Tatum1234/kahvibotti/test-data/calibration_log_20260927_1521.txt

Restored: machine on, carafe on, basket off, pot 0 g
!!! left HX711 not answering at start
>>> event: Käynnistys (alkuperäinen versio, syy: virta kytketty) 0 0
>>> Käynnistys (alkuperäinen versio, syy: virta kytketty)

>>> state: Tyhjä
t= 149613807 us  left :  -770224 raw   right:    -1826 raw    rawT=  -772050
t= 150437807 us  left :  -770229 raw   right:    -1812 raw    rawT=  -772041
t= 151261807 us  left :  -770199 raw   right:    -1844 raw    rawT=  -772043
t= 152084798 us  left :  -770179 raw   right:    -1841 raw    rawT=  -772020
t= 152826796 us  left :  -770173 raw   right:    -1890 raw    rawT=  -772063
t= 153649802 us  left :  -770189 raw   right:    -1909 raw    rawT=  -772098
t= 154473808 us  left :  -770124 raw   right:    -1910 raw    rawT=  -772034
t= 155214815 us  left :  -770253 raw   right:    -1974 raw    rawT=  -772227
t= 156038798 us  left :  -770239 raw   right:    -1875 raw    rawT=  -772114
t= 156862802 us  left :  -770227 raw   right:    -1867 raw    rawT=  -772094
t= 157603807 us  left :  -770182 raw   right:    -1882 raw    rawT=  -772064
t= 158427806 us  left :  -770238 raw   right:    -1864 raw    rawT=  -772102
t= 159251806 us  left :  -770158 raw   right:    -1841 raw    rawT=  -771999
t= 159992803 us  left :  -770184 raw   right:    -1855 raw    rawT=  -772039
t= 160816801 us  left :  -770172 raw   right:    -1921 raw    rawT=  -772093
t= 161639799 us  left :  -770178 raw   right:    -1882 raw    rawT=  -772060
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
t= 293243808 us  left :  -755480 raw   right:    53554 raw    rawT=  -701926
t= 294066807 us  left :  -755510 raw   right:    53580 raw    rawT=  -701930
t= 294808807 us  left :  -755553 raw   right:    53567 raw    rawT=  -701986
t= 295631808 us  left :  -755504 raw   right:    53547 raw    rawT=  -701957
t= 296455813 us  left :  -755506 raw   right:    53537 raw    rawT=  -701969
t= 297196799 us  left :  -755497 raw   right:    53554 raw    rawT=  -701943
t= 298020793 us  left :  -755482 raw   right:    53560 raw    rawT=  -701922
t= 298843821 us  left :  -755512 raw   right:    53556 raw    rawT=  -701956
t= 299584799 us  left :  -755510 raw   right:    53552 raw    rawT=  -701958
t= 300408800 us  left :  -755496 raw   right:    53539 raw    rawT=  -701957
t= 301231808 us  left :  -755504 raw   right:    53555 raw    rawT=  -701949
t= 302055807 us  left :  -755500 raw   right:    53600 raw    rawT=  -701900
t= 302796808 us  left :  -755517 raw   right:    53612 raw    rawT=  -701905
t= 303620807 us  left :  -755496 raw   right:    53607 raw    rawT=  -701889
t= 304443806 us  left :  -755531 raw   right:    53624 raw    rawT=  -701907
t= 305185798 us  left :  -755490 raw   right:    53606 raw    rawT=  -701884
t= 306008797 us  left :  -755508 raw   right:    53660 raw    rawT=  -701848
t= 306832805 us  left :  -755474 raw   right:    53656 raw    rawT=  -701818
t= 307573807 us  left :  -755527 raw   right:    53681 raw    rawT=  -701846
t= 308396811 us  left :  -755575 raw   right:    53722 raw    rawT=  -701853
t= 309220801 us  left :  -755536 raw   right:    53729 raw    rawT=  -701807
t= 309961806 us  left :  -755482 raw   right:    53691 raw    rawT=  -701791
t= 310785801 us  left :  -755501 raw   right:    53723 raw    rawT=  -701778
t= 311608802 us  left :  -755516 raw   right:    53726 raw    rawT=  -701790
t= 312350811 us  left :  -755527 raw   right:    53732 raw    rawT=  -701795

############ MARK t= 312860717 us: S3 carafe empty OUT r2 ############

t= 313173802 us  left :  -755567 raw   right:    53750 raw    rawT=  -701817
t= 313997802 us  left :  -755563 raw   right:    53780 raw    rawT=  -701783
t= 314820816 us  left :  -755554 raw   right:    53796 raw    rawT=  -701758
t= 315561807 us  left :  -755658 raw   right:    53788 raw    rawT=  -701870
t= 316385797 us  left :  -755674 raw   right:    53802 raw    rawT=  -701872
t= 317208820 us  left :  -755656 raw   right:    53884 raw    rawT=  -701772
t= 317949807 us  left :  -755687 raw   right:    53835 raw    rawT=  -701852
t= 318772807 us  left :  -755695 raw   right:    53848 raw    rawT=  -701847
t= 319596807 us  left :  -755727 raw   right:    53885 raw    rawT=  -701842
t= 320337794 us  left :  -755722 raw   right:    53849 raw    rawT=  -701873
t= 321160807 us  left :  -755678 raw   right:    53843 raw    rawT=  -701835
t= 321984814 us  left :  -755668 raw   right:    53837 raw    rawT=  -701831
t= 322725803 us  left :  -755707 raw   right:    53863 raw    rawT=  -701844
t= 323549808 us  left :  -755620 raw   right:    53926 raw    rawT=  -701694
t= 324372807 us  left :  -755632 raw   right:    53864 raw    rawT=  -701768
t= 325113799 us  left :  -755571 raw   right:    53909 raw    rawT=  -701662
t= 325937807 us  left :  -755624 raw   right:    53903 raw    rawT=  -701721
t= 326761791 us  left :  -755611 raw   right:    42379 raw    rawT=  -713232
t= 327502780 us  left :  -809276 raw   right:   -32775 raw    rawT=  -842051
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
t= 428706807 us  left :  -771600 raw   right:    -5134 raw    rawT=  -776734
t= 429529807 us  left :  -771546 raw   right:    -5285 raw    rawT=  -776831
t= 430352800 us  left :  -771491 raw   right:    -5319 raw    rawT=  -776810
t= 431176806 us  left :  -771447 raw   right:    -5341 raw    rawT=  -776788
t= 431917807 us  left :  -771403 raw   right:    -5445 raw    rawT=  -776848
t= 432740796 us  left :  -771387 raw   right:    -5471 raw    rawT=  -776858
t= 433564811 us  left :  -771375 raw   right:    -5521 raw    rawT=  -776896
t= 434305808 us  left :  -771333 raw   right:    -5525 raw    rawT=  -776858
t= 435128798 us  left :  -771294 raw   right:    -5576 raw    rawT=  -776870
t= 435952796 us  left :  -771279 raw   right:    -5661 raw    rawT=  -776940
t= 436693795 us  left :  -771232 raw   right:    -5675 raw    rawT=  -776907
t= 437516807 us  left :  -771227 raw   right:    -5766 raw    rawT=  -776993
t= 438339807 us  left :  -771198 raw   right:    -5757 raw    rawT=  -776955
t= 439080808 us  left :  -771193 raw   right:    -5819 raw    rawT=  -777012
t= 439904807 us  left :  -771173 raw   right:    -5866 raw    rawT=  -777039
t= 440727803 us  left :  -771163 raw   right:    -5835 raw    rawT=  -776998
t= 441468796 us  left :  -771136 raw   right:    -5881 raw    rawT=  -777017
t= 442291799 us  left :  -771144 raw   right:    -5867 raw    rawT=  -777011
t= 443114808 us  left :  -771082 raw   right:    -5883 raw    rawT=  -776965
t= 443938796 us  left :  -771076 raw   right:    -5951 raw    rawT=  -777027
t= 444679799 us  left :  -771069 raw   right:    -5938 raw    rawT=  -777007
t= 445502808 us  left :  -771043 raw   right:    -5969 raw    rawT=  -777012
t= 446326806 us  left :  -770941 raw   right:    -6022 raw    rawT=  -776963
t= 447067807 us  left :  -770945 raw   right:    -6054 raw    rawT=  -776999
t= 447891807 us  left :  -771033 raw   right:    -6089 raw    rawT=  -777122
t= 448714808 us  left :  -770977 raw   right:    -6121 raw    rawT=  -777098

############ MARK t= 449171719 us: S6 carafe empty IN r3 ############

t= 449455800 us  left :  -771015 raw   right:    -6140 raw    rawT=  -777155
t= 450279801 us  left :  -770977 raw   right:    -6157 raw    rawT=  -777134
t= 451102806 us  left :  -770941 raw   right:    -6120 raw    rawT=  -777061
t= 451843795 us  left :  -770945 raw   right:    -6211 raw    rawT=  -777156
t= 452667808 us  left :  -770942 raw   right:    -6188 raw    rawT=  -777130
t= 453490807 us  left :  -770946 raw   right:    -6196 raw    rawT=  -777142
t= 454231807 us  left :  -770998 raw   right:    -6232 raw    rawT=  -777230
t= 455055807 us  left :  -770966 raw   right:    -6223 raw    rawT=  -777189
t= 455878808 us  left :  -770956 raw   right:    -6242 raw    rawT=  -777198
t= 456619807 us  left :  -770932 raw   right:    -6304 raw    rawT=  -777236
t= 457360815 us  left :  -770948 raw   right:    -6299 raw    rawT=  -777247
t= 458183874 us  left :  -770904 raw   right:    -6296 raw    rawT=  -777200
t= 458924797 us  left :  -770896 raw   right:    -6310 raw    rawT=  -777206
t= 459747812 us  left :  -770885 raw   right:    -6297 raw    rawT=  -777182
t= 460571797 us  left :  -770775 raw   right:    -6257 raw    rawT=  -777032
t= 461312803 us  left :  -770673 raw   right:    -6383 raw    rawT=  -777056
t= 462135807 us  left :  -770655 raw   right:    -6345 raw    rawT=  -777000
t= 462959796 us  left :  -764987 raw   right:    -1452 raw    rawT=  -766439
t= 463700796 us  left :  -738876 raw   right:    34253 raw    rawT=  -704623
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
t= 506844807 us  left :  -769833 raw   right:    -7179 raw    rawT=  -777012
t= 507585803 us  left :  -769850 raw   right:    -7352 raw    rawT=  -777202
t= 508408801 us  left :  -769787 raw   right:    -7295 raw    rawT=  -777082
t= 509232820 us  left :  -769792 raw   right:    -7333 raw    rawT=  -777125
t= 509973808 us  left :  -769768 raw   right:    -7309 raw    rawT=  -777077
t= 510796804 us  left :  -769793 raw   right:    -7265 raw    rawT=  -777058
t= 511620812 us  left :  -769746 raw   right:    -7342 raw    rawT=  -777088
t= 512361805 us  left :  -769718 raw   right:    -7279 raw    rawT=  -776997
t= 513184803 us  left :  -769738 raw   right:    -7408 raw    rawT=  -777146
t= 514008815 us  left :  -769700 raw   right:    -7396 raw    rawT=  -777096
t= 514749807 us  left :  -769724 raw   right:    -7355 raw    rawT=  -777079
t= 515572803 us  left :  -769700 raw   right:    -7432 raw    rawT=  -777132
t= 516395797 us  left :  -769645 raw   right:    -7403 raw    rawT=  -777048
t= 517136801 us  left :  -769648 raw   right:    -7460 raw    rawT=  -777108
t= 517959803 us  left :  -769578 raw   right:    -7425 raw    rawT=  -777003
t= 518783803 us  left :  -769616 raw   right:    -7419 raw    rawT=  -777035
t= 519606808 us  left :  -769555 raw   right:    -7453 raw    rawT=  -777008
t= 520347810 us  left :  -769519 raw   right:    -7435 raw    rawT=  -776954
t= 521170803 us  left :  -769484 raw   right:    -7458 raw    rawT=  -776942
t= 521993803 us  left :  -769527 raw   right:    -7482 raw    rawT=  -777009
t= 522734819 us  left :  -769440 raw   right:    -7535 raw    rawT=  -776975
t= 523558803 us  left :  -769432 raw   right:    -7538 raw    rawT=  -776970
t= 524381798 us  left :  -769414 raw   right:    -7575 raw    rawT=  -776989
t= 525122796 us  left :  -769373 raw   right:    -7676 raw    rawT=  -777049
t= 525945807 us  left :  -769417 raw   right:    -7617 raw    rawT=  -777034
t= 526768802 us  left :  -769341 raw   right:    -7661 raw    rawT=  -777002
t= 527509795 us  left :  -769386 raw   right:    -7679 raw    rawT=  -777065

############ MARK t= 527875688 us: S8 basket IN ############

t= 528333807 us  left :  -769400 raw   right:    -7684 raw    rawT=  -777084
t= 529156807 us  left :  -769326 raw   right:    -7742 raw    rawT=  -777068
t= 529897807 us  left :  -769307 raw   right:    -7732 raw    rawT=  -777039
t= 530721805 us  left :  -769361 raw   right:    -7700 raw    rawT=  -777061
t= 531544807 us  left :  -769344 raw   right:    -7732 raw    rawT=  -777076
t= 532368801 us  left :  -769361 raw   right:    -7755 raw    rawT=  -777116
t= 533109808 us  left :  -769407 raw   right:    -7773 raw    rawT=  -777180
t= 533932804 us  left :  -769419 raw   right:    -7770 raw    rawT=  -777189
t= 534756803 us  left :  -769395 raw   right:    -7786 raw    rawT=  -777181
t= 535497795 us  left :  -769388 raw   right:    -7780 raw    rawT=  -777168
t= 536320796 us  left :  -769367 raw   right:    -7782 raw    rawT=  -777149
t= 537144802 us  left :  -769386 raw   right:    -7845 raw    rawT=  -777231
t= 537885808 us  left :  -769318 raw   right:    -7818 raw    rawT=  -777136
t= 538708807 us  left :  -769252 raw   right:    -7826 raw    rawT=  -777078
t= 539532789 us  left :  -769410 raw   right:    -3720 raw    rawT=  -773130
t= 540273791 us  left :  -743564 raw   right:    18458 raw    rawT=  -725106
t= 541096798 us  left :  -758252 raw   right:    18781 raw    rawT=  -739471
t= 541919790 us  left :  -758344 raw   right:    19077 raw    rawT=  -739267
>>> event: Suodatinsuppilo, kansi tai porot pois (askel) 37869 0
t= 542664080 us  left :  -758395 raw   right:    19234 raw    rawT=  -739161
t= 543483799 us  left :  -759104 raw   right:    19872 raw    rawT=  -739232
t= 544307800 us  left :  -759149 raw   right:    19986 raw    rawT=  -739163
t= 545130814 us  left :  -759150 raw   right:    19923 raw    rawT=  -739227
t= 545871812 us  left :  -759175 raw   right:    19988 raw    rawT=  -739187
t= 546694811 us  left :  -759172 raw   right:    20001 raw    rawT=  -739171
t= 547517807 us  left :  -759192 raw   right:    20002 raw    rawT=  -739190
t= 548258810 us  left :  -759192 raw   right:    20062 raw    rawT=  -739130
t= 549081806 us  left :  -759208 raw   right:    20037 raw    rawT=  -739171
t= 549905801 us  left :  -759245 raw   right:    20084 raw    rawT=  -739161
t= 550646806 us  left :  -759205 raw   right:    20083 raw    rawT=  -739122
t= 551469792 us  left :  -759217 raw   right:    20147 raw    rawT=  -739070
t= 552292799 us  left :  -759209 raw   right:    20122 raw    rawT=  -739087
t= 553033804 us  left :  -759217 raw   right:    20150 raw    rawT=  -739067
t= 553856818 us  left :  -759238 raw   right:    20137 raw    rawT=  -739101
t= 554679808 us  left :  -759257 raw   right:    20144 raw    rawT=  -739113
t= 555420806 us  left :  -759235 raw   right:    20185 raw    rawT=  -739050
t= 556244807 us  left :  -759250 raw   right:    20174 raw    rawT=  -739076
t= 557067804 us  left :  -759248 raw   right:    20173 raw    rawT=  -739075
t= 557890803 us  left :  -759201 raw   right:    20199 raw    rawT=  -739002
t= 558632807 us  left :  -759221 raw   right:    20165 raw    rawT=  -739056
t= 559455799 us  left :  -759197 raw   right:    20166 raw    rawT=  -739031
t= 560278802 us  left :  -759212 raw   right:    20172 raw    rawT=  -739040
t= 561019803 us  left :  -759227 raw   right:    20136 raw    rawT=  -739091
t= 561843808 us  left :  -759187 raw   right:    20148 raw    rawT=  -739039
t= 562666807 us  left :  -759187 raw   right:    20170 raw    rawT=  -739017
t= 563407816 us  left :  -759175 raw   right:    20161 raw    rawT=  -739014
t= 564231807 us  left :  -759154 raw   right:    20139 raw    rawT=  -739015
t= 565054812 us  left :  -759178 raw   right:    20135 raw    rawT=  -739043
t= 565795802 us  left :  -759173 raw   right:    20121 raw    rawT=  -739052
t= 566618792 us  left :  -759129 raw   right:    20143 raw    rawT=  -738986
t= 567441855 us  left :  -759134 raw   right:    20124 raw    rawT=  -739010
t= 568182800 us  left :  -759156 raw   right:    20104 raw    rawT=  -739052
t= 569005800 us  left :  -759119 raw   right:    20085 raw    rawT=  -739034
t= 569829805 us  left :  -759141 raw   right:    20089 raw    rawT=  -739052
t= 570652806 us  left :  -759122 raw   right:    20085 raw    rawT=  -739037
t= 571393807 us  left :  -759121 raw   right:    20093 raw    rawT=  -739028
t= 572216823 us  left :  -759135 raw   right:    20064 raw    rawT=  -739071
t= 573039807 us  left :  -759111 raw   right:    20047 raw    rawT=  -739064
t= 573780800 us  left :  -759074 raw   right:    20055 raw    rawT=  -739019

############ MARK t= 573970708 us: S9 basket OUT r2 ############

t= 574603796 us  left :  -759169 raw   right:    20051 raw    rawT=  -739118
t= 575427806 us  left :  -759139 raw   right:    20104 raw    rawT=  -739035
t= 576168795 us  left :  -759161 raw   right:    20022 raw    rawT=  -739139
t= 576991798 us  left :  -759111 raw   right:    20068 raw    rawT=  -739043
t= 577814806 us  left :  -759137 raw   right:    20071 raw    rawT=  -739066
t= 578555807 us  left :  -759115 raw   right:    20042 raw    rawT=  -739073
t= 579378807 us  left :  -759151 raw   right:    20069 raw    rawT=  -739082
t= 580201807 us  left :  -759156 raw   right:    20058 raw    rawT=  -739098
t= 580942802 us  left :  -759088 raw   right:    19981 raw    rawT=  -739107
t= 581766805 us  left :  -759077 raw   right:    20007 raw    rawT=  -739070
t= 582589807 us  left :  -759115 raw   right:    19999 raw    rawT=  -739116
t= 583412799 us  left :  -759026 raw   right:    20025 raw    rawT=  -739001
t= 584153813 us  left :  -759001 raw   right:    19551 raw    rawT=  -739450
t= 584976797 us  left :  -758358 raw   right:    19301 raw    rawT=  -739057
t= 585799802 us  left :  -758350 raw   right:    17553 raw    rawT=  -740797
t= 586540791 us  left :  -777399 raw   right:    14690 raw    rawT=  -762709
t= 587364792 us  left :  -765990 raw   right:      194 raw    rawT=  -765796
t= 588187791 us  left :  -765774 raw   right:    11451 raw    rawT=  -754323
t= 588928792 us  left :  -768636 raw   right:    -7564 raw    rawT=  -776200
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
t= 631985811 us  left :  -755219 raw   right:    -5849 raw    rawT=  -761068
t= 632809812 us  left :  -755165 raw   right:    -5854 raw    rawT=  -761019
t= 633632811 us  left :  -755179 raw   right:    -5822 raw    rawT=  -761001
t= 634373811 us  left :  -755179 raw   right:    -5859 raw    rawT=  -761038
t= 635197806 us  left :  -755146 raw   right:    -5858 raw    rawT=  -761004
t= 636020802 us  left :  -755155 raw   right:    -5855 raw    rawT=  -761010
t= 636844799 us  left :  -755138 raw   right:    -5857 raw    rawT=  -760995
t= 637585808 us  left :  -755149 raw   right:    -5896 raw    rawT=  -761045
t= 638408800 us  left :  -755134 raw   right:    -5873 raw    rawT=  -761007
t= 639231798 us  left :  -755077 raw   right:    -5875 raw    rawT=  -760952
t= 639973798 us  left :  -755046 raw   right:    -5937 raw    rawT=  -760983
t= 640796808 us  left :  -755048 raw   right:    -5913 raw    rawT=  -760961
t= 641619807 us  left :  -755048 raw   right:    -5918 raw    rawT=  -760966
t= 642360807 us  left :  -755027 raw   right:    -5981 raw    rawT=  -761008
t= 643184806 us  left :  -755001 raw   right:    -5947 raw    rawT=  -760948
t= 644007814 us  left :  -755007 raw   right:    -5966 raw    rawT=  -760973
t= 644748797 us  left :  -754967 raw   right:    -6032 raw    rawT=  -760999
t= 645572796 us  left :  -754998 raw   right:    -5987 raw    rawT=  -760985
t= 646395806 us  left :  -754982 raw   right:    -6021 raw    rawT=  -761003
t= 647136797 us  left :  -754996 raw   right:    -6037 raw    rawT=  -761033
t= 647960799 us  left :  -754988 raw   right:    -6067 raw    rawT=  -761055
t= 648783806 us  left :  -754946 raw   right:    -6031 raw    rawT=  -760977
t= 649524807 us  left :  -754948 raw   right:    -6040 raw    rawT=  -760988
t= 650348807 us  left :  -754958 raw   right:    -6073 raw    rawT=  -761031
t= 651171818 us  left :  -754943 raw   right:    -6040 raw    rawT=  -760983
t= 651994807 us  left :  -754931 raw   right:    -6106 raw    rawT=  -761037
t= 652735794 us  left :  -754909 raw   right:    -6093 raw    rawT=  -761002

############ MARK t= 653356720 us: S11 reservoir lid OFF ############

t= 653559796 us  left :  -754899 raw   right:    -6132 raw    rawT=  -761031
t= 654382811 us  left :  -754901 raw   right:    -6136 raw    rawT=  -761037
t= 655123804 us  left :  -754944 raw   right:    -6187 raw    rawT=  -761131
t= 655947807 us  left :  -754925 raw   right:    -6190 raw    rawT=  -761115
t= 656770801 us  left :  -754905 raw   right:    -6209 raw    rawT=  -761114
t= 657511807 us  left :  -754844 raw   right:    -6211 raw    rawT=  -761055
t= 658334892 us  left :  -754920 raw   right:    -6195 raw    rawT=  -761115
t= 659158806 us  left :  -754883 raw   right:    -6250 raw    rawT=  -761133
t= 659899807 us  left :  -754871 raw   right:    -6255 raw    rawT=  -761126
>>> mem: up 11 min, free 112600, min 87096, block 77812, stack left sensors 3532 telegram 5540 loop 5704
t= 660722798 us  left :  -754861 raw   right:    -6273 raw    rawT=  -761134
t= 661546798 us  left :  -754839 raw   right:    -6261 raw    rawT=  -761100
t= 662287797 us  left :  -754770 raw   right:    -6217 raw    rawT=  -760987
t= 663110808 us  left :  -754788 raw   right:    -6246 raw    rawT=  -761034
t= 663933808 us  left :  -754767 raw   right:    -5223 raw    rawT=  -759990
t= 664674784 us  left :  -776544 raw   right:   -32768 raw    rawT=  -809312
t= 665497793 us  left :  -798670 raw   right:   -48623 raw    rawT=  -847293
t= 666320793 us  left :  -771946 raw   right:   -18495 raw    rawT=  -790441
t= 667143792 us  left :  -790146 raw   right:    -7138 raw    rawT=  -797284
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
t= 710039811 us  left :  -764423 raw   right:    -2077 raw    rawT=  -766500
t= 710862804 us  left :  -764449 raw   right:    -2172 raw    rawT=  -766621
t= 711685808 us  left :  -764432 raw   right:    -2096 raw    rawT=  -766528
t= 712426810 us  left :  -764424 raw   right:    -2154 raw    rawT=  -766578
t= 713250804 us  left :  -764406 raw   right:    -2139 raw    rawT=  -766545
t= 714073801 us  left :  -764481 raw   right:    -1988 raw    rawT=  -766469
t= 714814812 us  left :  -764560 raw   right:    -2037 raw    rawT=  -766597
t= 715637815 us  left :  -764554 raw   right:    -1962 raw    rawT=  -766516
t= 716461801 us  left :  -764426 raw   right:    -1863 raw    rawT=  -766289
t= 717284807 us  left :  -764421 raw   right:    -1929 raw    rawT=  -766350
t= 718025807 us  left :  -764383 raw   right:    -1941 raw    rawT=  -766324
t= 718848802 us  left :  -764374 raw   right:    -1954 raw    rawT=  -766328
t= 719672802 us  left :  -764364 raw   right:    -1955 raw    rawT=  -766319
t= 720413800 us  left :  -764402 raw   right:    -1987 raw    rawT=  -766389
t= 721236808 us  left :  -764351 raw   right:    -2000 raw    rawT=  -766351
t= 722060800 us  left :  -764380 raw   right:    -2029 raw    rawT=  -766409
t= 722801796 us  left :  -764354 raw   right:    -1952 raw    rawT=  -766306
t= 723624807 us  left :  -764387 raw   right:    -1982 raw    rawT=  -766369
t= 724447807 us  left :  -764347 raw   right:    -1972 raw    rawT=  -766319
t= 725188807 us  left :  -764334 raw   right:    -1955 raw    rawT=  -766289
t= 726011808 us  left :  -764328 raw   right:    -1956 raw    rawT=  -766284
t= 726834990 us  left :  -764293 raw   right:    -2084 raw    rawT=  -766377
t= 727575807 us  left :  -764275 raw   right:    -2078 raw    rawT=  -766353
t= 728398803 us  left :  -764269 raw   right:    -2133 raw    rawT=  -766402
t= 729221806 us  left :  -764300 raw   right:    -2159 raw    rawT=  -766459

############ MARK t= 729449730 us: S13 basket cover OFF ############

t= 729962796 us  left :  -764365 raw   right:    -2204 raw    rawT=  -766569
t= 730785798 us  left :  -764258 raw   right:    -2219 raw    rawT=  -766477
t= 731609807 us  left :  -764253 raw   right:    -2220 raw    rawT=  -766473
t= 732432803 us  left :  -764296 raw   right:    -2252 raw    rawT=  -766548
t= 733173807 us  left :  -764235 raw   right:    -2276 raw    rawT=  -766511
t= 733996808 us  left :  -764258 raw   right:    -2241 raw    rawT=  -766499
t= 734819806 us  left :  -764276 raw   right:    -2261 raw    rawT=  -766537
t= 735560807 us  left :  -764317 raw   right:    -2299 raw    rawT=  -766616
t= 736383801 us  left :  -764302 raw   right:    -2283 raw    rawT=  -766585
t= 737207806 us  left :  -764257 raw   right:    -2306 raw    rawT=  -766563
t= 737948807 us  left :  -764275 raw   right:    -2312 raw    rawT=  -766587
t= 738771796 us  left :  -764230 raw   right:    -2276 raw    rawT=  -766506
t= 739594799 us  left :  -764272 raw   right:    -2323 raw    rawT=  -766595
t= 740335808 us  left :  -764268 raw   right:    -2353 raw    rawT=  -766621
t= 741159806 us  left :  -764255 raw   right:    -2352 raw    rawT=  -766607
t= 741982808 us  left :  -764217 raw   right:    -2286 raw    rawT=  -766503
t= 742723807 us  left :  -764220 raw   right:    -2364 raw    rawT=  -766584
t= 743547807 us  left :  -764198 raw   right:    -2330 raw    rawT=  -766528
t= 744370803 us  left :  -764180 raw   right:    -2412 raw    rawT=  -766592
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
t= 847111803 us  left :  -770991 raw   right:   -16939 raw    rawT=  -787930
t= 847935806 us  left :  -770886 raw   right:   -16915 raw    rawT=  -787801
t= 848676938 us  left :  -770870 raw   right:   -17049 raw    rawT=  -787919
t= 849499809 us  left :  -770809 raw   right:   -16964 raw    rawT=  -787773
t= 850322807 us  left :  -770906 raw   right:   -17234 raw    rawT=  -788140
t= 851063808 us  left :  -770891 raw   right:   -16931 raw    rawT=  -787822
t= 851887806 us  left :  -770753 raw   right:   -16966 raw    rawT=  -787719
t= 852710799 us  left :  -770764 raw   right:   -17027 raw    rawT=  -787791
t= 853533817 us  left :  -770692 raw   right:   -16980 raw    rawT=  -787672
t= 854274806 us  left :  -770719 raw   right:   -17128 raw    rawT=  -787847
t= 855098819 us  left :  -770690 raw   right:   -17067 raw    rawT=  -787757
t= 855921805 us  left :  -770674 raw   right:   -17080 raw    rawT=  -787754
t= 856662806 us  left :  -770666 raw   right:   -17094 raw    rawT=  -787760
t= 857485806 us  left :  -770655 raw   right:   -17107 raw    rawT=  -787762
t= 858308807 us  left :  -770621 raw   right:   -17152 raw    rawT=  -787773
t= 859049818 us  left :  -770569 raw   right:   -17127 raw    rawT=  -787696
t= 859873807 us  left :  -770546 raw   right:   -17180 raw    rawT=  -787726
t= 860696796 us  left :  -770516 raw   right:   -17175 raw    rawT=  -787691
t= 861437795 us  left :  -770481 raw   right:   -17191 raw    rawT=  -787672
t= 862260811 us  left :  -770502 raw   right:   -17243 raw    rawT=  -787745
t= 863084809 us  left :  -770474 raw   right:   -17186 raw    rawT=  -787660
t= 863825797 us  left :  -770478 raw   right:   -17263 raw    rawT=  -787741
t= 864648808 us  left :  -770407 raw   right:   -17278 raw    rawT=  -787685
t= 865471807 us  left :  -770409 raw   right:   -17285 raw    rawT=  -787694
t= 866212818 us  left :  -770346 raw   right:   -17308 raw    rawT=  -787654
t= 867036808 us  left :  -770274 raw   right:   -17328 raw    rawT=  -787602
t= 867859807 us  left :  -770360 raw   right:   -17462 raw    rawT=  -787822
t= 868682800 us  left :  -770334 raw   right:   -17486 raw    rawT=  -787820

############ MARK t= 868852720 us: S15 basket cover ON ############

t= 869423792 us  left :  -770418 raw   right:   -17504 raw    rawT=  -787922
t= 870247877 us  left :  -770356 raw   right:   -17546 raw    rawT=  -787902
t= 871070808 us  left :  -770402 raw   right:   -17520 raw    rawT=  -787922
t= 871811812 us  left :  -770430 raw   right:   -17572 raw    rawT=  -788002
t= 872634808 us  left :  -770401 raw   right:   -17571 raw    rawT=  -787972
t= 873458184 us  left :  -770364 raw   right:   -17569 raw    rawT=  -787933
t= 874198817 us  left :  -770363 raw   right:   -17583 raw    rawT=  -787946
t= 875022807 us  left :  -770378 raw   right:   -17612 raw    rawT=  -787990
t= 875845806 us  left :  -770385 raw   right:   -17604 raw    rawT=  -787989
t= 876586797 us  left :  -770336 raw   right:   -17606 raw    rawT=  -787942
t= 877409799 us  left :  -770350 raw   right:   -17678 raw    rawT=  -788028
t= 878232793 us  left :  -770327 raw   right:   -17692 raw    rawT=  -788019
t= 878973807 us  left :  -770334 raw   right:   -17651 raw    rawT=  -787985
t= 879797796 us  left :  -770319 raw   right:   -17693 raw    rawT=  -788012
t= 880620808 us  left :  -770348 raw   right:   -17684 raw    rawT=  -788032
t= 881361807 us  left :  -770320 raw   right:   -17729 raw    rawT=  -788049
t= 882184807 us  left :  -770271 raw   right:   -17707 raw    rawT=  -787978
t= 883007807 us  left :  -770255 raw   right:   -17732 raw    rawT=  -787987
t= 883830806 us  left :  -770246 raw   right:   -17780 raw    rawT=  -788026
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
t=2091053804 us  left :  -621863 raw   right:     6988 raw    rawT=  -614875
t=2091876803 us  left :  -621821 raw   right:     6950 raw    rawT=  -614871
t=2092616810 us  left :  -621798 raw   right:     6920 raw    rawT=  -614878
