Tatum1234/kahvibotti/test-data/calibration_log_20260923_1406.txt

=== Kahvibotti calibration (XIAO ESP32-C3) ===
Known reference mass: 177.00 g (change with "m <grams>")
Commands:
  z          tare both channels (empty platform)
  m <grams>  set known reference mass

  h          this help

t=   8904988 us  t=  51446984 us  left :  -419729 raw   right:  -572887 raw    rawT=  -992616
t=  52860986 us  left :  -419753 raw   right:  -572871 raw    rawT=  -992624
t=  54019984 us  left :  -419732 raw   right:  -572876 raw    rawT=  -992608
t=  55168986 us  left :  -419747 raw   right:  -572879 raw    rawT=  -992626
t=  56327984 us  left :  -419738 raw   right:  -572868 raw    rawT=  -992606
t=  57394986 us  left :  -419742 raw   right:  -572856 raw    rawT=  -992598
t=  58553984 us  left :  -419752 raw   right:  -572908 raw    rawT=  -992660
t=  59702986 us  left :  -419726 raw   right:  -572919 raw    rawT=  -992645
t=  60861984 us  left :  -419722 raw   right:  -572893 raw    rawT=  -992615
t=  62010986 us  left :  -419739 raw   right:  -572916 raw    rawT=  -992655
t=  63087984 us  left :  -419759 raw   right:  -572920 raw    rawT=  -992679
t=  64236986 us  left :  -419746 raw   right:  -572949 raw    rawT=  -992695
t=  65395984 us  left :  -419748 raw   right:  -572952 raw    rawT=  -992700
t=  66544986 us  left :  -419760 raw   right:  -572908 raw    rawT=  -992668
t=  67703984 us  left :  -419782 raw   right:  -572942 raw    rawT=  -992724
t=  68769986 us  left :  -419775 raw   right:  -572948 raw    rawT=  -992723
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
t= 131335984 us  left :  -420028 raw   right:  -573127 raw    rawT=  -993155
t= 132484986 us  left :  -420024 raw   right:  -573123 raw    rawT=  -993147
t= 133643984 us  left :  -420017 raw   right:  -573107 raw    rawT=  -993124
t= 134792986 us  left :  -420029 raw   right:  -573175 raw    rawT=  -993204
t= 135951984 us  left :  -420037 raw   right:  -573170 raw    rawT=  -993207
t= 137017986 us  left :  -420017 raw   right:  -573151 raw    rawT=  -993168
t= 138177984 us  left :  -420024 raw   right:  -573191 raw    rawT=  -993215
t= 139326986 us  left :  -419974 raw   right:  -573187 raw    rawT=  -993161
t= 140485984 us  left :  -419979 raw   right:  -573167 raw    rawT=  -993146
t= 141634986 us  left :  -420042 raw   right:  -573174 raw    rawT=  -993216
Tared both channels.
t= 146080620 us  left :       44 raw   right:       19 raw    rawT=       63
t= 147243984 us  left :       -6 raw   right:      -17 raw    rawT=      -23
t= 148392986 us  left :       51 raw   right:      -19 raw    rawT=       32
t= 149551984 us  left :       41 raw   right:      -46 raw    rawT=       -5
t= 150700986 us  left :       80 raw   right:      -54 raw    rawT=       26
t= 151858984 us  left :       48 raw   right:      -36 raw    rawT=       12
t= 153007986 us  left :       79 raw   right:      -17 raw    rawT=       62
t= 154083984 us  left :       16 raw   right:        5 raw    rawT=       21

############ MARK t= 155233120 us: A0 all fitted dry, tared ############

t= 155233232 us  left :       53 raw   right:      -37 raw    rawT=       16
t= 156391984 us  left :       36 raw   right:      -35 raw    rawT=        1
t= 157539986 us  left :       43 raw   right:      -58 raw    rawT=      -15
t= 158698984 us  left :       72 raw   right:      -91 raw    rawT=      -19
t= 159764986 us  left :       34 raw   right:      -84 raw    rawT=      -50
t= 160923984 us  left :       49 raw   right:      -87 raw    rawT=      -38
t= 162072986 us  left :       56 raw   right:      -75 raw    rawT=      -19
t= 163231984 us  left :       58 raw   right:      -89 raw    rawT=      -31
t= 164379986 us  left :       80 raw   right:     -100 raw    rawT=      -20
t= 165456984 us  left :      100 raw   right:      -97 raw    rawT=        3
t= 166605986 us  left :       64 raw   right:      -91 raw    rawT=      -27
t= 167763984 us  left :       84 raw   right:     -142 raw    rawT=      -58
t= 168912986 us  left :      100 raw   right:     -108 raw    rawT=       -8
t= 170071984 us  left :       96 raw   right:     -118 raw    rawT=      -22
t= 171137986 us  left :      112 raw   right:      -99 raw    rawT=       13
t= 172296984 us  left :       72 raw   right:      -76 raw    rawT=       -4
t= 173444986 us  left :       65 raw   right:     -117 raw    rawT=      -52
t= 174603984 us  left :       64 raw   right:     -128 raw    rawT=      -64
t= 175752986 us  left :       38 raw   right:     -141 raw    rawT=     -103
t= 176828984 us  left :       77 raw   right:     -114 raw    rawT=      -37
t= 177977986 us  left :       56 raw   right:     -125 raw    rawT=      -69
t= 179135984 us  left :      102 raw   right:     -115 raw    rawT=      -13
t= 180284986 us  left :       91 raw   right:     -126 raw    rawT=      -35
t= 181443984 us  left :      138 raw   right:     -149 raw    rawT=      -11
t= 182510986 us  left :       98 raw   right:     -159 raw    rawT=      -61
t= 183669984 us  left :      143 raw   right:     -127 raw    rawT=       16
t= 184818986 us  left :      121 raw   right:     -162 raw    rawT=      -41
t= 185977984 us  left :      134 raw   right:     -160 raw    rawT=      -26
t= 187126986 us  left :      109 raw   right:     -160 raw    rawT=      -51
t= 188202984 us  left :      109 raw   right:     -302 raw    rawT=     -193
t= 189351986 us  left :    -3453 raw   right:     1101 raw    rawT=    -2352
t= 190510984 us  left :    10466 raw   right:     3922 raw    rawT=    14388
t= 191658986 us  left :    10446 raw   right:     3947 raw    rawT=    14393
t= 192817984 us  left :    10476 raw   right:     3906 raw    rawT=    14382
t= 193883986 us  left :    10623 raw   right:     3833 raw    rawT=    14456
t= 195042984 us  left :    10592 raw   right:     3816 raw    rawT=    14408
t= 196191986 us  left :    10634 raw   right:     3844 raw    rawT=    14478
t= 197349984 us  left :    10626 raw   right:     3876 raw    rawT=    14502
t= 198498986 us  left :    10578 raw   right:     4383 raw    rawT=    14961
t= 199575984 us  left :     9747 raw   right:     4869 raw    rawT=    14616
t= 200724986 us  left :     9840 raw   right:     4840 raw    rawT=    14680
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
t= 522540984 us  left :     8457 raw   right:    17699 raw    rawT=    26156
t= 523689986 us  left :     8445 raw   right:    17688 raw    rawT=    26133
t= 524848984 us  left :     8430 raw   right:    17715 raw    rawT=    26145
t= 525997986 us  left :     8444 raw   right:    17674 raw    rawT=    26118
t= 527073984 us  left :     8486 raw   right:    17684 raw    rawT=    26170
t= 528222986 us  left :     8443 raw   right:    17691 raw    rawT=    26134
t= 529381984 us  left :     8455 raw   right:    17699 raw    rawT=    26154
t= 530529986 us  left :     8427 raw   right:    17696 raw    rawT=    26123
t= 531688984 us  left :     8426 raw   right:    17677 raw    rawT=    26103
t= 532755986 us  left :     8448 raw   right:    17715 raw    rawT=    26163
t= 533913984 us  left :     8419 raw   right:    17678 raw    rawT=    26097
t= 535062986 us  left :     8421 raw   right:    17715 raw    rawT=    26136
t= 536221984 us  left :     8444 raw   right:    17672 raw    rawT=    26116
t= 537370986 us  left :     8425 raw   right:    17718 raw    rawT=    26143
t= 538446984 us  left :     8426 raw   right:    17682 raw    rawT=    26108
t= 539595986 us  left :     8426 raw   right:    17688 raw    rawT=    26114
t= 540754984 us  left :     8451 raw   right:    17699 raw    rawT=    26150
t= 541902986 us  left :     8433 raw   right:    17697 raw    rawT=    26130
t= 543061984 us  left :     8385 raw   right:    17692 raw    rawT=    26077
t= 544128986 us  left :     8447 raw   right:    17689 raw    rawT=    26136
t= 545286984 us  left :     8411 raw   right:    17693 raw    rawT=    26104
t= 546435986 us  left :     8445 raw   right:    17664 raw    rawT=    26109
t= 547594984 us  left :     8397 raw   right:    17716 raw    rawT=    26113
t= 548743986 us  left :     8442 raw   right:    17729 raw    rawT=    26171
t= 549819984 us  left :     8406 raw   right:    17720 raw    rawT=    26126
t= 550968986 us  left :     8436 raw   right:    17672 raw    rawT=    26108
t= 552126984 us  left :     8413 raw   right:    17700 raw    rawT=    26113
t= 553275986 us  left :     8431 raw   right:    17694 raw    rawT=    26125
t= 554434984 us  left :     8419 raw   right:    17711 raw    rawT=    26130
t= 555500986 us  left :     8409 raw   right:    17675 raw    rawT=    26084

############ MARK t= 556660085 us: A6 r1 both covers OFF ############

t= 556660198 us  left :     8434 raw   right:    17697 raw    rawT=    26131
t= 557807986 us  left :     8449 raw   right:    17664 raw    rawT=    26113
t= 558966984 us  left :     8461 raw   right:    17693 raw    rawT=    26154
t= 560115986 us  left :     8458 raw   right:    17691 raw    rawT=    26149
t= 561191984 us  left :     8486 raw   right:    17600 raw    rawT=    26086
t= 562340986 us  left :     8435 raw   right:    17672 raw    rawT=    26107
t= 563499984 us  left :     8444 raw   right:    17696 raw    rawT=    26140
t= 564648986 us  left :     8451 raw   right:    17672 raw    rawT=    26123
t= 565806984 us  left :     8426 raw   right:    17641 raw    rawT=    26067
t= 566873986 us  left :     8464 raw   right:    17717 raw    rawT=    26181
t= 568031984 us  left :     8387 raw   right:    17691 raw    rawT=    26078
t= 569180986 us  left :     8371 raw   right:    17452 raw    rawT=    25823
t= 570338984 us  left :    25318 raw   right:     2703 raw    rawT=    28021
t= 571487986 us  left :    11964 raw   right:     2808 raw    rawT=    14772
t= 572563984 us  left :    11837 raw   right:    -1460 raw    rawT=    10377
t= 573712986 us  left :    -8922 raw   right:    -1076 raw    rawT=    -9998
t= 574870984 us  left :     1531 raw   right:    -1200 raw    rawT=      331
t= 576019986 us  left :     1338 raw   right:    -1215 raw    rawT=      123
t= 577178984 us  left :     1031 raw   right:     -933 raw    rawT=       98
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
t= 639637986 us  left :    11489 raw   right:     2900 raw    rawT=    14389
t= 640796984 us  left :    11412 raw   right:     2848 raw    rawT=    14260
t= 641944986 us  left :    11411 raw   right:     2851 raw    rawT=    14262
t= 643102984 us  left :    11095 raw   right:     2923 raw    rawT=    14018
t= 644169986 us  left :    11104 raw   right:     3022 raw    rawT=    14126
t= 645327984 us  left :    11056 raw   right:     3001 raw    rawT=    14057
t= 646475986 us  left :    10948 raw   right:     3636 raw    rawT=    14584
t= 647634984 us  left :    10913 raw   right:     3162 raw    rawT=    14075
t= 648782986 us  left :    11119 raw   right:     3044 raw    rawT=    14163
t= 649858984 us  left :    11095 raw   right:     3117 raw    rawT=    14212
t= 651007986 us  left :    11092 raw   right:     3128 raw    rawT=    14220
t= 652165984 us  left :    11092 raw   right:     3045 raw    rawT=    14137
t= 653314986 us  left :    11104 raw   right:     3079 raw    rawT=    14183
t= 654472984 us  left :    11128 raw   right:     3077 raw    rawT=    14205
t= 655538986 us  left :    11141 raw   right:     3104 raw    rawT=    14245
t= 656697984 us  left :    11124 raw   right:     3047 raw    rawT=    14171
t= 657845986 us  left :    11135 raw   right:     3085 raw    rawT=    14220
t= 659004984 us  left :    11149 raw   right:     3037 raw    rawT=    14186
t= 660152986 us  left :    11147 raw   right:     3059 raw    rawT=    14206
t= 661228984 us  left :    11135 raw   right:     3033 raw    rawT=    14168
t= 662377986 us  left :    11148 raw   right:     3068 raw    rawT=    14216
t= 663535984 us  left :    11203 raw   right:     3033 raw    rawT=    14236
t= 664684986 us  left :    11172 raw   right:     3083 raw    rawT=    14255
t= 665842984 us  left :    11170 raw   right:     3032 raw    rawT=    14202
t= 666991986 us  left :    11193 raw   right:     3017 raw    rawT=    14210
t= 668149984 us  left :    11176 raw   right:     3057 raw    rawT=    14233
t= 669215986 us  left :    11215 raw   right:     3045 raw    rawT=    14260
t= 670374984 us  left :    11220 raw   right:     3028 raw    rawT=    14248
t= 671522986 us  left :    11197 raw   right:     3065 raw    rawT=    14262
t= 672681984 us  left :    11201 raw   right:     3067 raw    rawT=    14268
t= 673829986 us  left :    11178 raw   right:     3056 raw    rawT=    14234
t= 674905984 us  left :    11214 raw   right:     3051 raw    rawT=    14265

############ MARK t= 676054081 us: A1 r2 res cover OFF ############

t= 676054194 us  left :    11209 raw   right:     3056 raw    rawT=    14265
t= 677212984 us  left :    11257 raw   right:     3016 raw    rawT=    14273
t= 678360986 us  left :    11220 raw   right:     3017 raw    rawT=    14237
t= 679519984 us  left :    11313 raw   right:     3015 raw    rawT=    14328
t= 680585986 us  left :    11261 raw   right:     2998 raw    rawT=    14259
t= 681744984 us  left :    11264 raw   right:     3014 raw    rawT=    14278
t= 682892986 us  left :    11279 raw   right:     3050 raw    rawT=    14329
t= 684051984 us  left :    11261 raw   right:     3027 raw    rawT=    14288
t= 685199986 us  left :    11267 raw   right:     3012 raw    rawT=    14279
t= 686276984 us  left :    11231 raw   right:     3017 raw    rawT=    14248
t= 687424986 us  left :    11399 raw   right:     2882 raw    rawT=    14281
t= 688583984 us  left :    11179 raw   right:     2950 raw    rawT=    14129
t= 689732986 us  left :    16642 raw   right:   -13484 raw    rawT=     3158
t= 690891984 us  left :   -23668 raw   right:     1990 raw    rawT=   -21678
t= 691957986 us  left :     -288 raw   right:    -1392 raw    rawT=    -1680
t= 693116984 us  left :     1587 raw   right:    -1151 raw    rawT=      436
t= 694265986 us  left :     1444 raw   right:    -1106 raw    rawT=      338
t= 695424984 us  left :     1379 raw   right:    -1125 raw    rawT=      254
t= 696572986 us  left :     1369 raw   right:    -1122 raw    rawT=      247
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
t= 759044984 us  left :    -1625 raw   right:    13589 raw    rawT=    11964
t= 760193986 us  left :    -1662 raw   right:    13595 raw    rawT=    11933
t= 761352984 us  left :    -1696 raw   right:    13595 raw    rawT=    11899
t= 762501986 us  left :    -1675 raw   right:    13587 raw    rawT=    11912
t= 763577984 us  left :    -1670 raw   right:    13576 raw    rawT=    11906
t= 764726986 us  left :    -1660 raw   right:    13610 raw    rawT=    11950
t= 765885984 us  left :    -1660 raw   right:    13597 raw    rawT=    11937
t= 767033986 us  left :    -1655 raw   right:    13610 raw    rawT=    11955
t= 768192984 us  left :    -1670 raw   right:    13592 raw    rawT=    11922
t= 769259986 us  left :    -1733 raw   right:    13584 raw    rawT=    11851
t= 770417984 us  left :    -1677 raw   right:    13587 raw    rawT=    11910
t= 771566986 us  left :    -1687 raw   right:    13584 raw    rawT=    11897
t= 772725984 us  left :    -1719 raw   right:    13579 raw    rawT=    11860
t= 773873986 us  left :    -1690 raw   right:    13571 raw    rawT=    11881
t= 774950984 us  left :    -1707 raw   right:    13600 raw    rawT=    11893
t= 776098986 us  left :    -1692 raw   right:    13563 raw    rawT=    11871
t= 777257984 us  left :    -1676 raw   right:    13557 raw    rawT=    11881
t= 778406986 us  left :    -1690 raw   right:    13578 raw    rawT=    11888
t= 779565984 us  left :    -1683 raw   right:    13552 raw    rawT=    11869
t= 780631986 us  left :    -1714 raw   right:    13571 raw    rawT=    11857
t= 781790984 us  left :    -1708 raw   right:    13589 raw    rawT=    11881
t= 782938986 us  left :    -1733 raw   right:    13543 raw    rawT=    11810
t= 784097984 us  left :    -1707 raw   right:    13578 raw    rawT=    11871
t= 785246986 us  left :    -1665 raw   right:    13530 raw    rawT=    11865
t= 786322984 us  left :    -1670 raw   right:    13557 raw    rawT=    11887
t= 787471986 us  left :    -1723 raw   right:    13549 raw    rawT=    11826
t= 788630984 us  left :    -1720 raw   right:    13551 raw    rawT=    11831

############ MARK t= 789780084 us: A3 r2 bask cover OFF ############

t= 789780196 us  left :    -1707 raw   right:    13572 raw    rawT=    11865
t= 790937984 us  left :    -1676 raw   right:    13552 raw    rawT=    11876
t= 792004986 us  left :    -1659 raw   right:    13573 raw    rawT=    11914
t= 793162984 us  left :    -1689 raw   right:    13553 raw    rawT=    11864
t= 794311986 us  left :    -1677 raw   right:    13566 raw    rawT=    11889
t= 795387984 us  left :    -1648 raw   right:    13545 raw    rawT=    11897
t= 796536986 us  left :    -1649 raw   right:    13534 raw    rawT=    11885
t= 797695984 us  left :    -1633 raw   right:    13554 raw    rawT=    11921
t= 798844986 us  left :    -1660 raw   right:    13541 raw    rawT=    11881
t= 800002984 us  left :    -1688 raw   right:    13560 raw    rawT=    11872
t= 801069986 us  left :    -1674 raw   right:    13519 raw    rawT=    11845
t= 802227984 us  left :    -1662 raw   right:    13536 raw    rawT=    11874
t= 803376986 us  left :    -1681 raw   right:    13503 raw    rawT=    11822
t= 804535984 us  left :    -1773 raw   right:    13544 raw    rawT=    11771
t= 805684986 us  left :      103 raw   right:    -6664 raw    rawT=    -6561
t= 806760984 us  left :     1681 raw   right:    -1223 raw    rawT=      458
t= 807908986 us  left :     1633 raw   right:    -1242 raw    rawT=      391
t= 809067984 us  left :     1645 raw   right:    -1261 raw    rawT=      384
t= 810215986 us  left :     1678 raw   right:    -1281 raw    rawT=      397
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
t=1162732986 us  left :    -1314 raw   right:    13252 raw    rawT=    11938
t=1163891984 us  left :    -1295 raw   right:    13269 raw    rawT=    11974
t=1164957986 us  left :    -1293 raw   right:    13243 raw    rawT=    11950
t=1166116984 us  left :    -1275 raw   right:    13237 raw    rawT=    11962
t=1167265986 us  left :    -1270 raw   right:    13265 raw    rawT=    11995
t=1168423984 us  left :    -1234 raw   right:    13232 raw    rawT=    11998
t=1169572986 us  left :    -1248 raw   right:    13234 raw    rawT=    11986
t=1170648984 us  left :    -1308 raw   right:    13289 raw    rawT=    11981
t=1171797986 us  left :    -1284 raw   right:    13255 raw    rawT=    11971
t=1172956984 us  left :    -1335 raw   right:    13261 raw    rawT=    11926
t=1174104986 us  left :    -1276 raw   right:    13289 raw    rawT=    12013
t=1175263984 us  left :    -1236 raw   right:    13245 raw    rawT=    12009
t=1176329986 us  left :    -1321 raw   right:    13221 raw    rawT=    11900
t=1177487984 us  left :    -1257 raw   right:    13246 raw    rawT=    11989
t=1178636986 us  left :    -1280 raw   right:    13226 raw    rawT=    11946
t=1179712984 us  left :    -1275 raw   right:    13222 raw    rawT=    11947
t=1180861986 us  left :    -1289 raw   right:    13236 raw    rawT=    11947
t=1182019984 us  left :    -1301 raw   right:    13263 raw    rawT=    11962
t=1183168986 us  left :    -1274 raw   right:    13233 raw    rawT=    11959
t=1184327984 us  left :    -1276 raw   right:    13242 raw    rawT=    11966
t=1185393986 us  left :    -1289 raw   right:    13204 raw    rawT=    11915
t=1186552984 us  left :    -1252 raw   right:    13223 raw    rawT=    11971
t=1187700986 us  left :    -1313 raw   right:    13257 raw    rawT=    11944
t=1188859984 us  left :    -1263 raw   right:    13250 raw    rawT=    11987
t=1190008986 us  left :    -1302 raw   right:    13235 raw    rawT=    11933
t=1191084984 us  left :    -1313 raw   right:    13240 raw    rawT=    11927
t=1192233986 us  left :    -1281 raw   right:    13228 raw    rawT=    11947

############ MARK t=1193393082 us: A3 r3 bask cover OFF ############

t=1193393192 us  left :    -1271 raw   right:    13163 raw    rawT=    11892
t=1194540986 us  left :    -1218 raw   right:    13160 raw    rawT=    11942
t=1195699984 us  left :    -1226 raw   right:    13162 raw    rawT=    11936
t=1196765986 us  left :    -1199 raw   right:    13181 raw    rawT=    11982
t=1197924984 us  left :    -1236 raw   right:    13148 raw    rawT=    11912
t=1199073986 us  left :    -1275 raw   right:    13196 raw    rawT=    11921
t=1200231984 us  left :    -1231 raw   right:    13167 raw    rawT=    11936
t=1201380986 us  left :    -1205 raw   right:    13194 raw    rawT=    11989
t=1202456984 us  left :    -1247 raw   right:    13167 raw    rawT=    11920
t=1203605986 us  left :    -1221 raw   right:    13143 raw    rawT=    11922
t=1204764984 us  left :    -3640 raw   right:     6216 raw    rawT=     2576
t=1205913986 us  left :     1526 raw   right:    -1624 raw    rawT=      -98
t=1207071984 us  left :     2695 raw   right:    -1967 raw    rawT=      728
t=1208137986 us  left :     1155 raw   right:    -1563 raw    rawT=     -408
t=1209295984 us  left :     1993 raw   right:    -1553 raw    rawT=      440
t=1210444986 us  left :     2108 raw   right:    -1673 raw    rawT=      435
t=1211602984 us  left :     1927 raw   right:    -1642 raw    rawT=      285
t=1212751986 us  left :     1919 raw   right:    -1632 raw    rawT=      287
t=1213827984 us  left :     1931 raw   right:    -1627 raw    rawT=      304
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
t=1483342986 us  left :    -7253 raw   right:    46475 raw    rawT=    39222
t=1484500984 us  left :    -7214 raw   right:    46450 raw    rawT=    39236
t=1485649986 us  left :    -7259 raw   right:    46481 raw    rawT=    39222
t=1486725984 us  left :    -7237 raw   right:    46459 raw    rawT=    39222
t=1487873986 us  left :    -7252 raw   right:    46458 raw    rawT=    39206
t=1489032984 us  left :    -7300 raw   right:    46467 raw    rawT=    39167
t=1490181986 us  left :    -7276 raw   right:    46479 raw    rawT=    39203
t=1491339984 us  left :    -7300 raw   right:    46468 raw    rawT=    39168
t=1492406986 us  left :    -7298 raw   right:    46456 raw    rawT=    39158

############ MARK t=1493566091 us: A8 basket empty dry OUT ############

t=1493566206 us  left :    -7283 raw   right:    46449 raw    rawT=    39166
t=1494713986 us  left :    -7316 raw   right:    46452 raw    rawT=    39136
t=1495872984 us  left :    -7295 raw   right:    46459 raw    rawT=    39164
t=1497020986 us  left :    -7306 raw   right:    46439 raw    rawT=    39133
t=1498096984 us  left :    -7290 raw   right:    46448 raw    rawT=    39158
t=1499245986 us  left :    -7301 raw   right:    46401 raw    rawT=    39100
t=1500403984 us  left :    -7298 raw   right:    46440 raw    rawT=    39142
t=1501552986 us  left :    -7319 raw   right:    46446 raw    rawT=    39127
t=1502710984 us  left :    -7328 raw   right:    46461 raw    rawT=    39133
t=1503776986 us  left :    -7345 raw   right:    46468 raw    rawT=    39123
t=1504935984 us  left :    -7336 raw   right:    46452 raw    rawT=    39116
t=1506083986 us  left :    29596 raw   right:    75028 raw    rawT=   104624
t=1507242984 us  left :   -21259 raw   right:    55345 raw    rawT=    34086
t=1508390986 us  left :   -31995 raw   right:    -2943 raw    rawT=   -34938
t=1509466984 us  left :      185 raw   right:    11167 raw    rawT=    11352
t=1510615986 us  left :    21714 raw   right:    17227 raw    rawT=    38941
t=1511774984 us  left :     5695 raw   right:    23884 raw    rawT=    29579
t=1512922986 us  left :    -1513 raw   right:    13020 raw    rawT=    11507
t=1514081984 us  left :     -885 raw   right:    12953 raw    rawT=    12068
t=1515148986 us  left :   -13227 raw   right:   -13978 raw    rawT=   -27205
t=1516306984 us  left :     1027 raw   right:    -1802 raw    rawT=     -775
t=1517455986 us  left :     1933 raw   right:    -1829 raw    rawT=      104
t=1518614984 us  left :     1964 raw   right:    -1864 raw    rawT=      100
t=1519763986 us  left :     2079 raw   right:    -1819 raw    rawT=      260
t=1520839984 us  left :     2078 raw   right:    -1846 raw    rawT=      232
t=1521988986 us  left :     2074 raw   right:    -1825 raw    rawT=      249
t=1523146984 us  left :     2105 raw   right:    -1878 raw    rawT=      227
t=1524295986 us  left :     2036 raw   right:    -1842 raw    rawT=      194
t=1525454984 us  left :     2026 raw   right:    -1798 raw    rawT=      228
t=1526520986 us  left :     2014 raw   right:    -1846 raw    rawT=      168
t=1527679984 us  left :     2046 raw   right:    -1830 raw    rawT=      216
t=1528828986 us  left :     2050 raw   right:    -1873 raw    rawT=      177
t=1529986984 us  left :     2097 raw   right:    -1810 raw    rawT=      287
t=1531134986 us  left :     2013 raw   right:    -1860 raw    rawT=      153
t=1532211984 us  left :     2033 raw   right:    -1837 raw    rawT=      196
t=1533359986 us  left :     2023 raw   right:    -1832 raw    rawT=      191
t=1534518984 us  left :     2045 raw   right:    -1890 raw    rawT=      155
t=1535667986 us  left :     2016 raw   right:    -1856 raw    rawT=      160
t=1536825984 us  left :     2029 raw   right:    -1826 raw    rawT=      203
t=1537892986 us  left :     2064 raw   right:    -1808 raw    rawT=      256
t=1539051984 us  left :     2004 raw   right:    -1844 raw    rawT=      160
t=1540199986 us  left :     2004 raw   right:    -1819 raw    rawT=      185
t=1541358984 us  left :     2006 raw   right:    -1827 raw    rawT=      179
t=1542506986 us  left :     1992 raw   right:    -1865 raw    rawT=      127
t=1543582984 us  left :     2045 raw   right:    -1870 raw    rawT=      175
t=1544731986 us  left :     2028 raw   right:    -1855 raw    rawT=      173
t=1545889984 us  left :     1999 raw   right:    -1845 raw    rawT=      154
t=1547038986 us  left :     2029 raw   right:    -1833 raw    rawT=      196
t=1548196984 us  left :     2041 raw   right:    -1850 raw    rawT=      191
t=1549262986 us  left :     2026 raw   right:    -1825 raw    rawT=      201

############ MARK t=1550422051 us: A9 basket ON ############

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
t=1599362986 us  left :   -26369 raw   right:   113408 raw    rawT=    87039
t=1600438984 us  left :   -26371 raw   right:   113382 raw    rawT=    87011
t=1601586986 us  left :   -26369 raw   right:   113355 raw    rawT=    86986
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
