Tatum1234/kahvibotti/firmware/kahvibotti/telegram_roots.h

// Root certificates trusted for api.telegram.org. Telegram's chain today (checked 2026-09-25):
// api.telegram.org -> Go Daddy Secure CA G2 (to 2031) -> Go Daddy Root G2. The library pins only that root,
// so a CA change at Telegram would silence the bot until someone uploads new firmware. The three extra roots
// cover the other common public CAs (Let's Encrypt, DigiCert, Sectigo/USERTrust). mbedTLS tries each; every
// extra root costs ~1.5 KB of heap during a handshake. Taken from the PC's system trust store; the device
// doesn't check validity dates (no MBEDTLS_HAVE_TIME_DATE), so expiry years don't matter here.
#pragma once
const char TELEGRAM_ROOTS[] = R"=EOF=(
-----BEGIN CERTIFICATE-----
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
4uJEvlz36hz1
-----END CERTIFICATE-----
-----BEGIN CERTIFICATE-----
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
-----END CERTIFICATE-----
-----BEGIN CERTIFICATE-----
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
MrY=
-----END CERTIFICATE-----
-----BEGIN CERTIFICATE-----
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
jjxDah2nGN59PRbxYvnKkKj9
-----END CERTIFICATE-----
)=EOF=";
