Tatum1234/kahvibotti/(commit log)

2026-09-26 Kahvibotti: a Telegram coffee bot on a load-cell platform
    A Moccamaster stands on a wooden platform with load cells; a XIAO ESP32-C3
    works out from per-side weight changes whether coffee is brewing, how many
    cups are left and when someone is pouring, and answers /kahvi in Telegram.
    - Scale logic in plain C++ (kahvi_core.h), replay-tested against 13 labelled
    logs of real brews, plus stats and a 2-year soak test
    - Web panel (Info, Tilastot, Huolto, Wi-Fi, Ohjelmisto), browser OTA with
    rollback, Wi-Fi fallback hotspot, milestones, long-run failsafes
    - Calibration sketch and photos of the build
    [partitions.csv]
2026-09-27 Final firmware: robustness fixes, fast Tilastot, new milestones
    - Telegram: all requests through one bounded HTTPS reader (the library's
    truncated at 1500 chars and could wedge on one long update), /kahvi spam
    guard by message time, four trusted root CAs, reconnect/restart if
    Telegram stays silent while Wi-Fi is up, clock from the HTTP Date header
    - Tilastot: binary search in the time-ordered stats file, one date
    conversion per record (~0.2 s per view even with a full storage)
    - Persistence: queue of up to 8 brews waiting for a clock, restarts wait
    for a running brew, checked stats save/clear, safer two-key NVS writes,
    crash-only firmware fallback counting
    - Web: login-page XSS a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
    [admin.h, fw_update.h, kahvi_core.h, kahvibotti.ino, stats_core.h, stats_test.cpp, wifi_setup.h]
2026-09-27 Recalibrate after a load cell moved (run S)
    A load cell shifted in real use: the empty carafe now reads 74.5k counts
    (was ~90k), 210 counts per gram of coffee (was 252), the water moving
    during a brew shows 132 counts per gram on the left cell (was 214), and
    the carafe's left/right pattern flipped sign. Basket, reservoir and
    machine steps are unchanged.
    - kahvi::Calib groups the geometry-dependent values; CALIB_S is used on
    the device, CALIB_A_R keeps the older logs and synthetic tests valid
    - Run S added as a labelled replay log (6-cup brew, 42 g grounds, carafe
    lifts, machine off/on); 230 checks pass
    - Soak test runs two simulated years for both geometries
    - Wait up to 1 s for the fir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
    [kahvi_core.h, kahvibotti.ino, replay_test.cpp, soak_test.cpp]
